eggsacc/CDE1302-drone-frame/README.md

# CDE1302 Drone frame re-design

Files & documentation for CDE1302 drone frame design. The updated frame is designed to be printed without any supports.

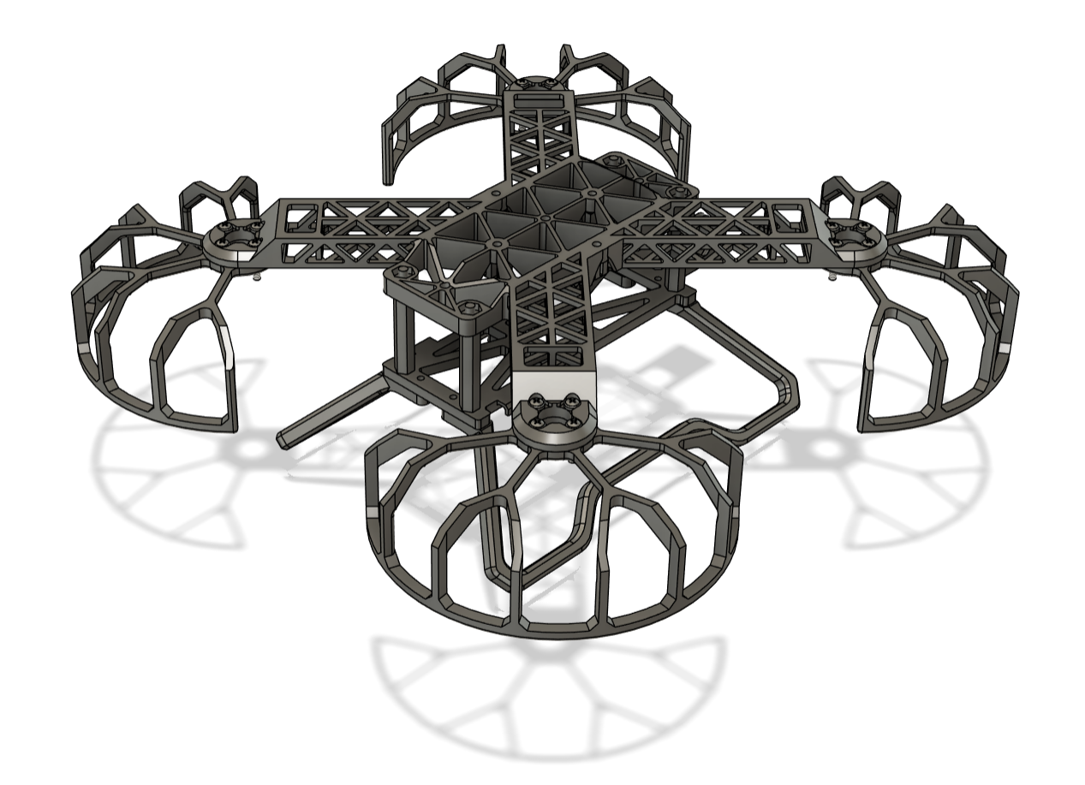
[picture p1: assets/image.png]
