eggsacc/CDE1302-drone-frame/STLs/import_together/main_frame.stl

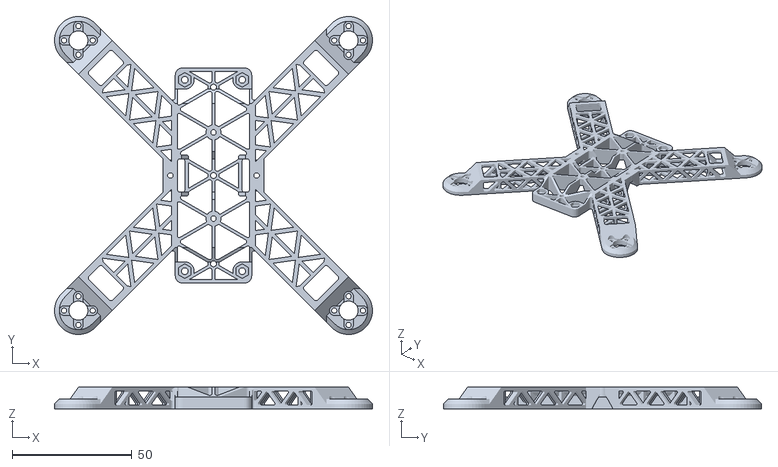
[picture p12: CAD file, 2026-09-10]
STLs/import_together/main_frame.stl
133.0 x 133.0 x 9.00
