eggsacc/CDE1302-drone-frame/STLs/bottom_panel.stl

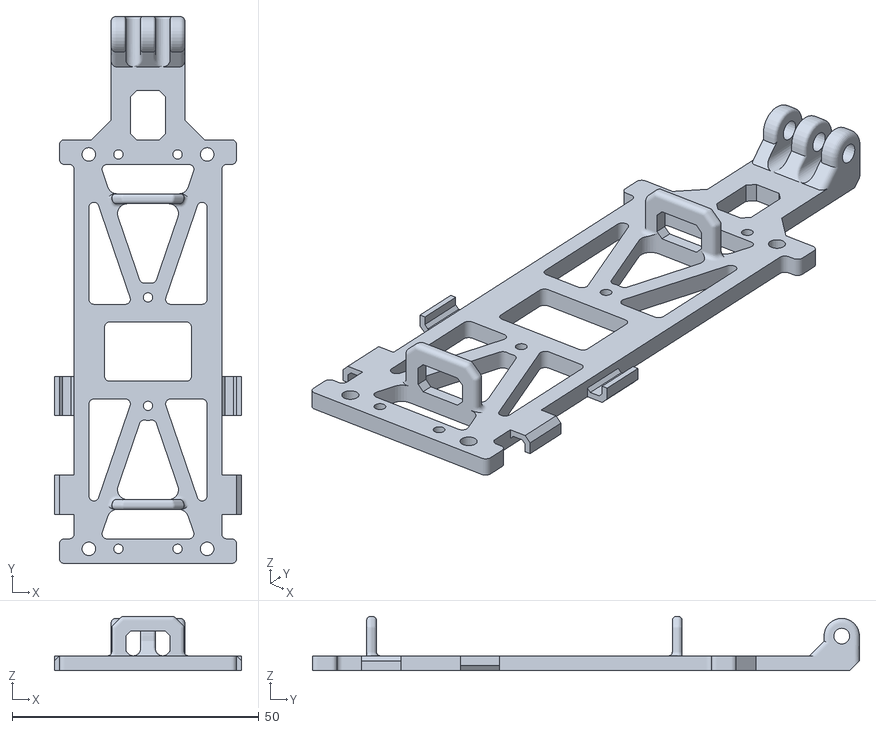
[picture p13: CAD file, 2026-09-10]
STLs/bottom_panel.stl
38.0 x 110.9 x 11.0
