eggsacc/CDE1302-drone-frame/STLs/import_together/s4.stl

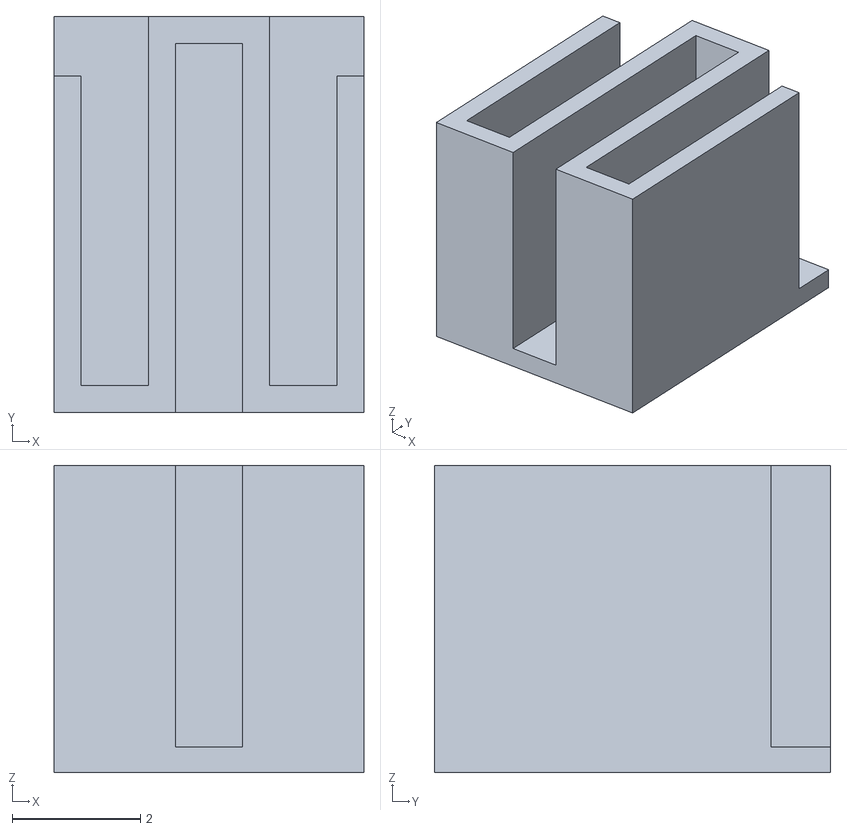
[picture p14: CAD file, 2026-09-10]
STLs/import_together/s4.stl
4.84 x 6.19 x 4.80
