eggsacc/CDE1302-drone-frame/STLs/prop_guard(x4).stl

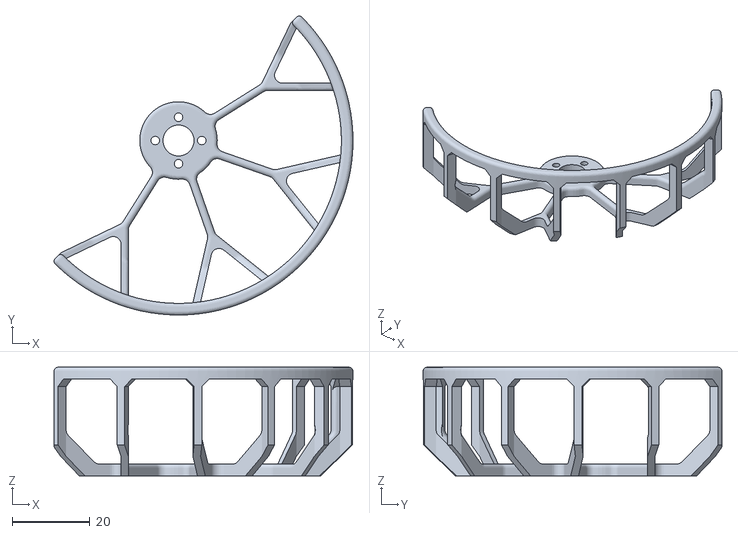
[picture p15: CAD file, 2026-09-10]
STLs/prop_guard(x4).stl
77.1 x 77.1 x 28.0
