eggsacc/CDE1302-drone-frame/STLs/mtf02p_cover.stl

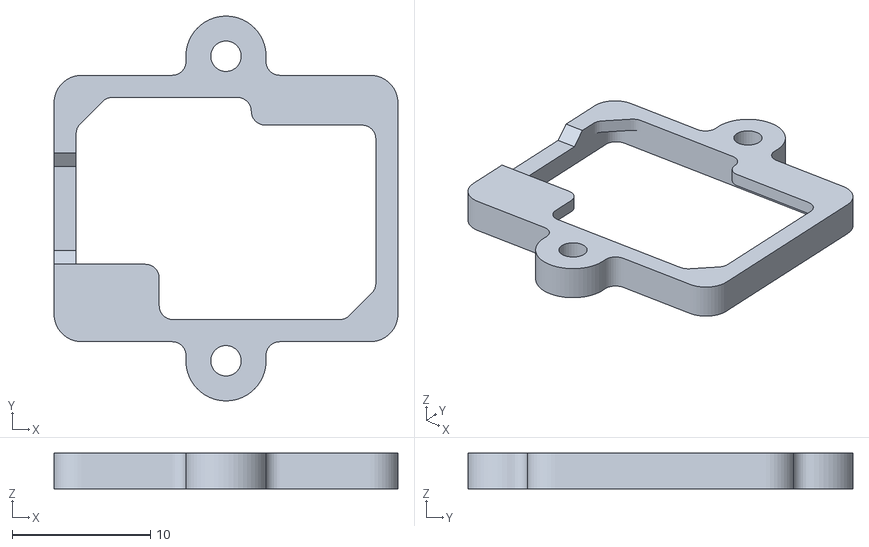
[picture p16: CAD file, 2026-09-10]
STLs/mtf02p_cover.stl
24.9 x 27.8 x 2.60
