eggsacc/CDE1302-drone-frame/STLs/import_together/s2.stl

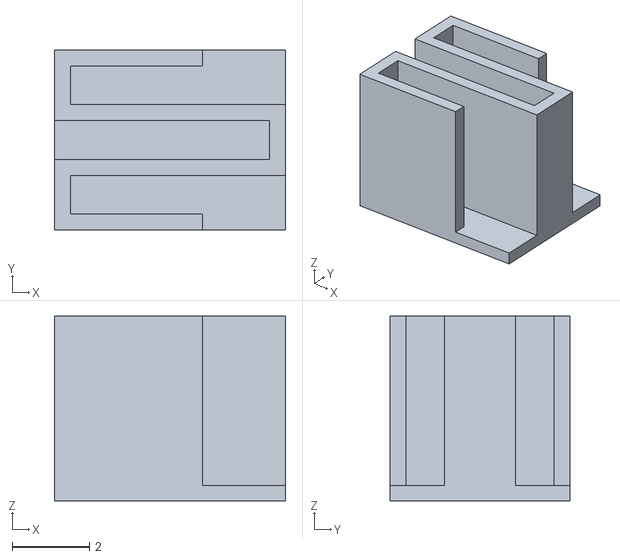
[picture p17: CAD file, 2026-09-10]
STLs/import_together/s2.stl
6.00 x 4.68 x 4.80
