eggsacc/CDE1302-drone-frame/STLs/landing_leg(x2).stl

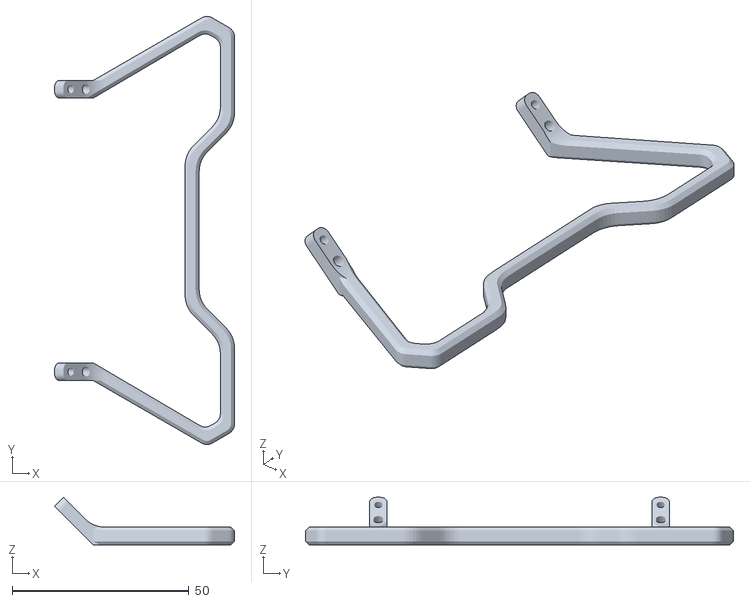
[picture p18: CAD file, 2026-09-10]
STLs/landing_leg(x2).stl
51.0 x 121.2 x 13.5
