eggsacc/CDE1302-drone-frame/(list of files, cad)

Other CAD files:
STLs/import_together/s3.stl
STLs/import_together/s1.stl
drone-fusion.f3z
